Ganzaru/PIXI_LAMP/stl/rods.stl

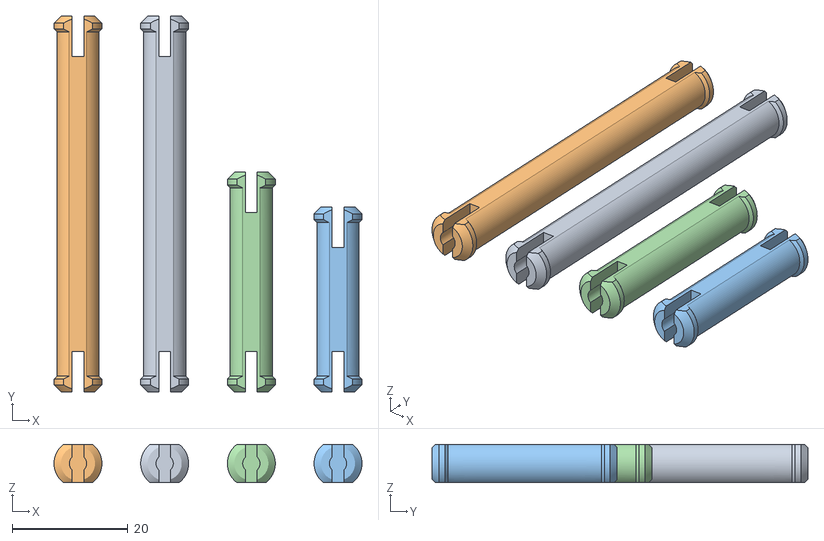
[picture p17: CAD file, 2018-05-06]
stl/rods.stl
53.3 x 65.0 x 6.64
