Ganzaru/PIXI_LAMP/stl/neck.stl

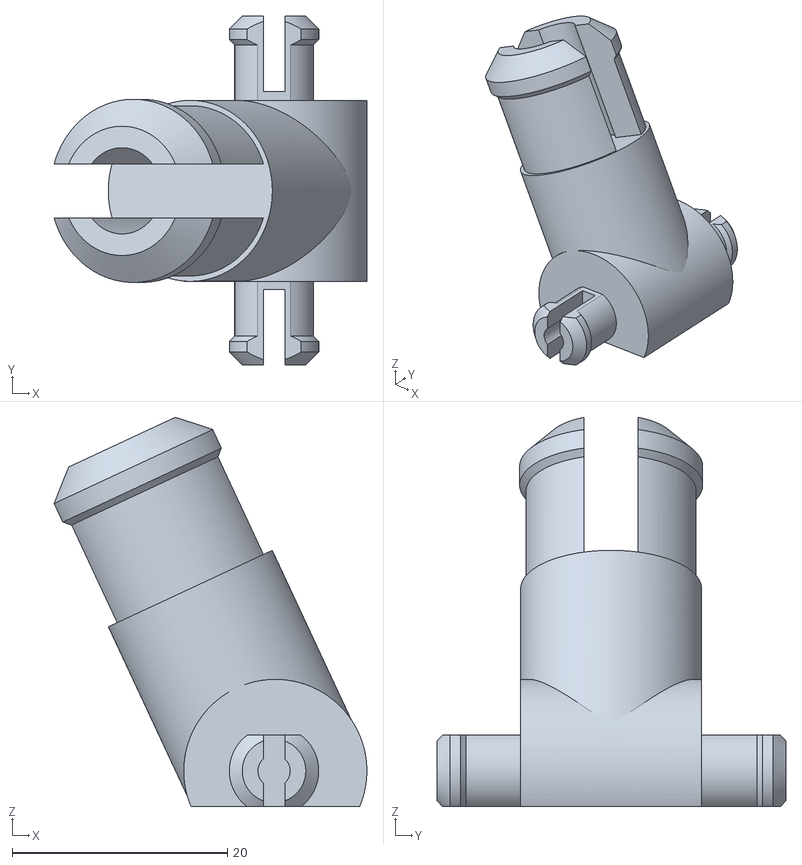
[picture p18: CAD file, 2018-05-06]
stl/neck.stl
29.0 x 32.4 x 36.1
