Ganzaru/PIXI_LAMP/stl/snap-in-neopixel12-mount_20161210.stl

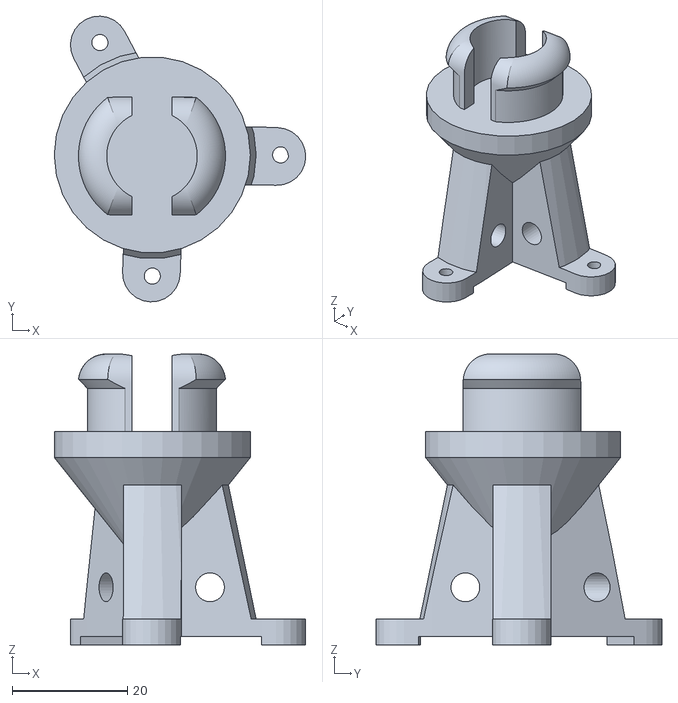
[picture p19: CAD file, 2018-05-06]
stl/snap-in-neopixel12-mount_20161210.stl
43.6 x 49.5 x 50.5
