Ganzaru/PIXI_LAMP/stl/stem.stl

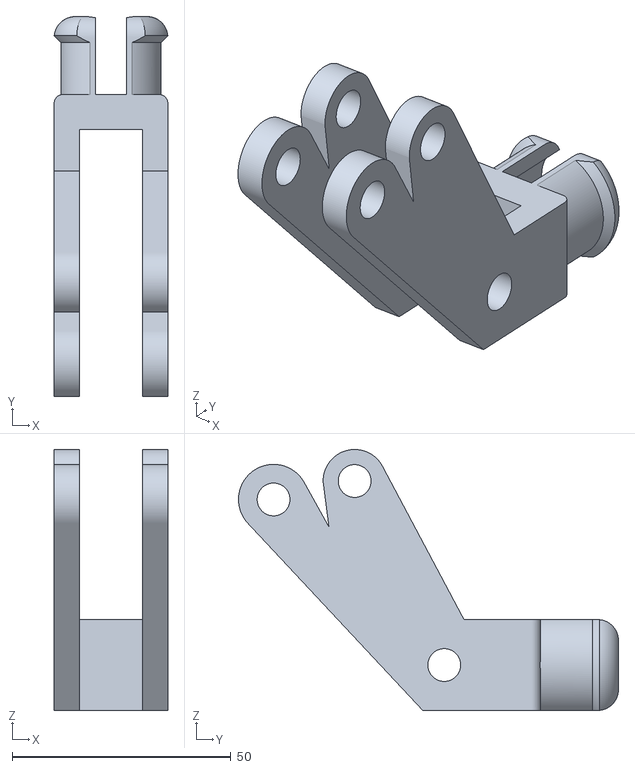
[picture p20: CAD file, 2018-05-06]
stl/stem.stl
26.0 x 86.9 x 59.7
