Ganzaru/PIXI_LAMP/stl/hinges.stl

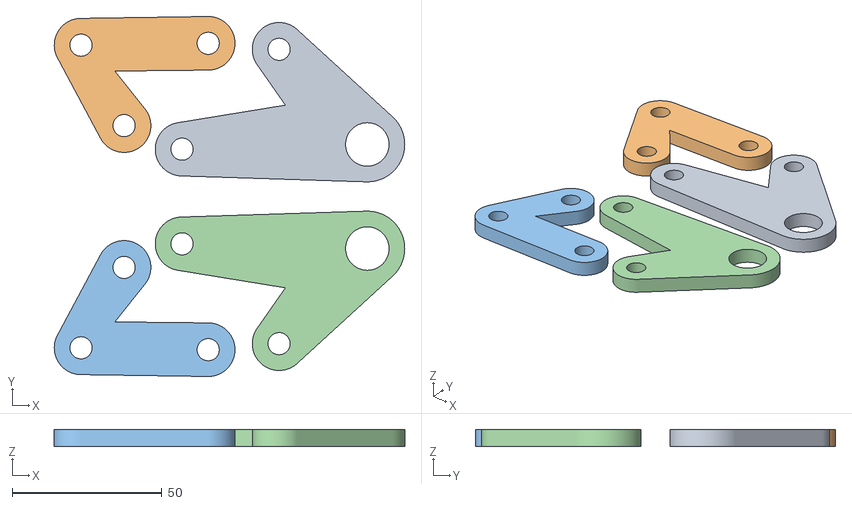
[picture p21: CAD file, 2018-05-06]
stl/hinges.stl
117.1 x 120.2 x 5.75
