Ganzaru/PIXI_LAMP/stl/box_sections.stl

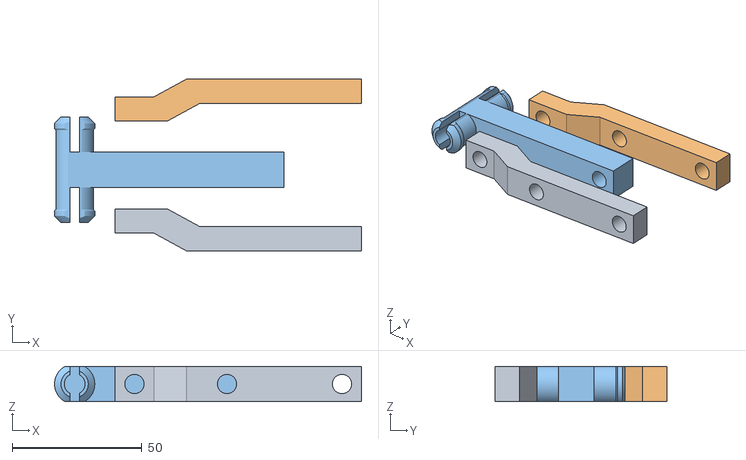
[picture p22: CAD file, 2018-05-06]
stl/box_sections.stl
118.1 x 66.2 x 13.5
