Ganzaru/PIXI_LAMP/stl/links.stl

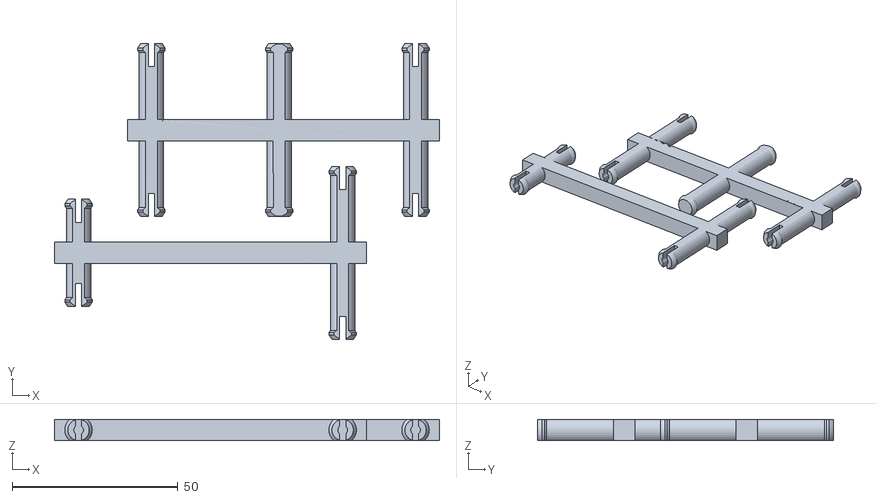
[picture p23: CAD file, 2018-05-06]
stl/links.stl
116.2 x 89.4 x 6.47
