Ganzaru/PIXI_LAMP/src/testFakePWM.py

class PWM():
	
	def __init__(self):
		print 'PWM init'

	def PCA9685(self):
		print 'PCA9685'

	def set_pwm(self, f1,f2,f3):
		#print 'pwm' + str(f1) + ' ' + str(f2) + ' ' + str(f3)
		return
		
	def set_pwm_freq(self, freq):
		print 'Set pwm freq - ' + str(freq)
