Ganzaru/PIXI_LAMP/(commit log)

2018-05-06 Upload of files
    [box_sections.stl, hinges.stl, links.stl, neck.stl, rods.stl, snap-in-neopixel12-mount_20161210.stl, stem.stl]
2018-05-06 actualización
    Actualización de ficheros
